Rolbista/MidiBoi/(commit log)

2026-09-02 Feat/cleanup arduino setup (#10)
    * Migrate build to arduino-cli with pinned dependencies
    Add sketch.yaml pinning arduino:avr and all six libraries to exact
    versions. Profile builds are isolated from the global sketchbook, which
    held floating git clones (Control-Surface sat 681 commits past a tag).
    Rename switcher_one_pot.ino to MidiBoi.ino; arduino-cli requires the
    main sketch filename to match the directory name. Contents unchanged.
    Add Makefile targets for build/upload/monitor and tools/gen-clangd.sh
    for editor config, replacing the deprecated VS Code Arduino extension.
    * Add flash and EEPROM dump of the prototype device
    Full read-out taken before any re-flash. The image on the device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
2026-11-04 enable setting MIDI ranges on CC potentiometers (#9)
    * fix clangd config generation on a clean checkout
    arduino-cli 1.5.x unpacks a profile's pinned toolchain into
    ~/Library/Arduino15/internal rather than packages/, so gen-clangd.sh found no
    avr-libc headers and 'make db' failed on any machine without a globally
    installed core. Ask arduino-cli for its data directory and search both
    locations.
    Claude-Session: https://claude.ai/code/session_016Lf8j4KD8UeAJDfJsQtaGA
    * add per-wheel CC and output range configuration, fix encoder reads
    Drops the Bank<120> machinery. MIDIFilteredAnalog::setAddress() has always
    allowed changing a controller number at runtime, so the banks were never
    needed; rem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
2026-11-04 fix wheel 1 lower range, stop sending duplicate CC values (#11)
    Two unrelated defects, both found by measuring the raw ADC over USB serial
    rather than reading a MIDI monitor. A monitor reports post-hysteresis values,
    so it reads systematically narrower than true travel -- which is how the
    original calibration bounds came to be set from biased data.
    Wheel 1 could not reach the bottom of its output range. Its lower calibration
    bound was 3 * 128 (ADC 24), but the wheel only travels down to ADC 52, so it
    never reached the clamp in calibrate() and bottomed out at a 7-bit value of 4.
    Through an output window of L=64/H=127 that surfaced as 66 instead of 64. The
    bound is now 12 * 128 (ADC 96), thre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
